realraum/luefterklappensteuerung/elektronik/lüfterklappenelektronik.pdf

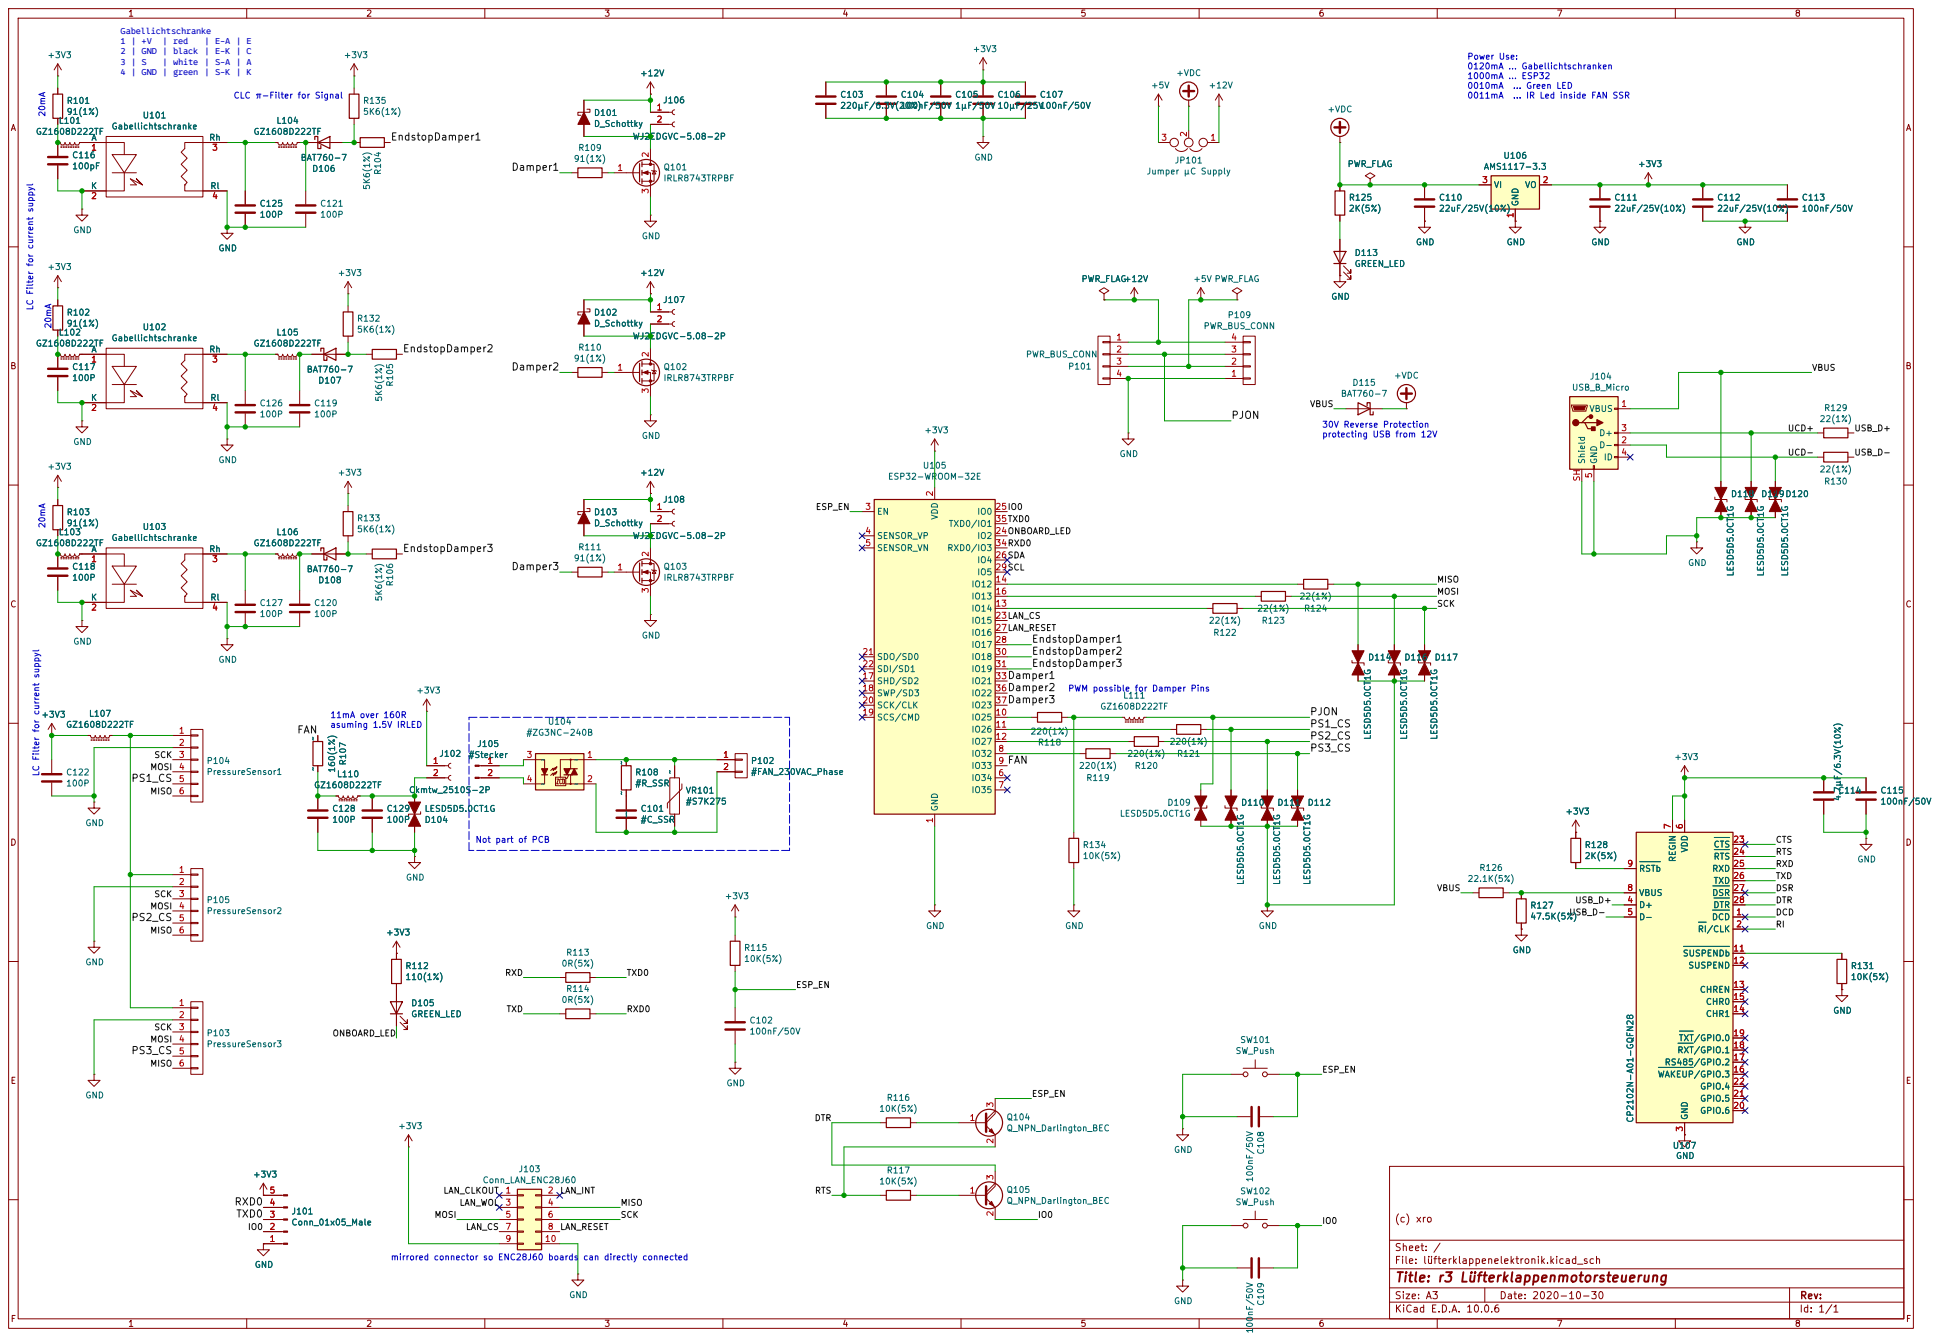
[picture p1: page 1]

0010mA ... Green LED
0011mA ... IR Led inside FAN SSR

protecting USB from 12V CLC π-Filter for Signal

Jumper µC Supply L101 GZ1608D222TF GND

LAN_CS LC Filter for current suppyl 20mALC Filter for current suppyl

4 P101 PWR_BUS_CONN 3 | | 2

PWM possible for Damper Pins VR101 #S7K275

Not part of PCB

Size: A3 | Rev: | F Date: 2020-10-30
KiCad E.D.A. 10.0.6 | Id: 1/1
