realraum/luefterklappensteuerung/elektronik/lüfterklappenelektronik.kicad_pcb

## KiCad design elektronik/lüfterklappenelektronik.kicad_pcb (2026-09-16)

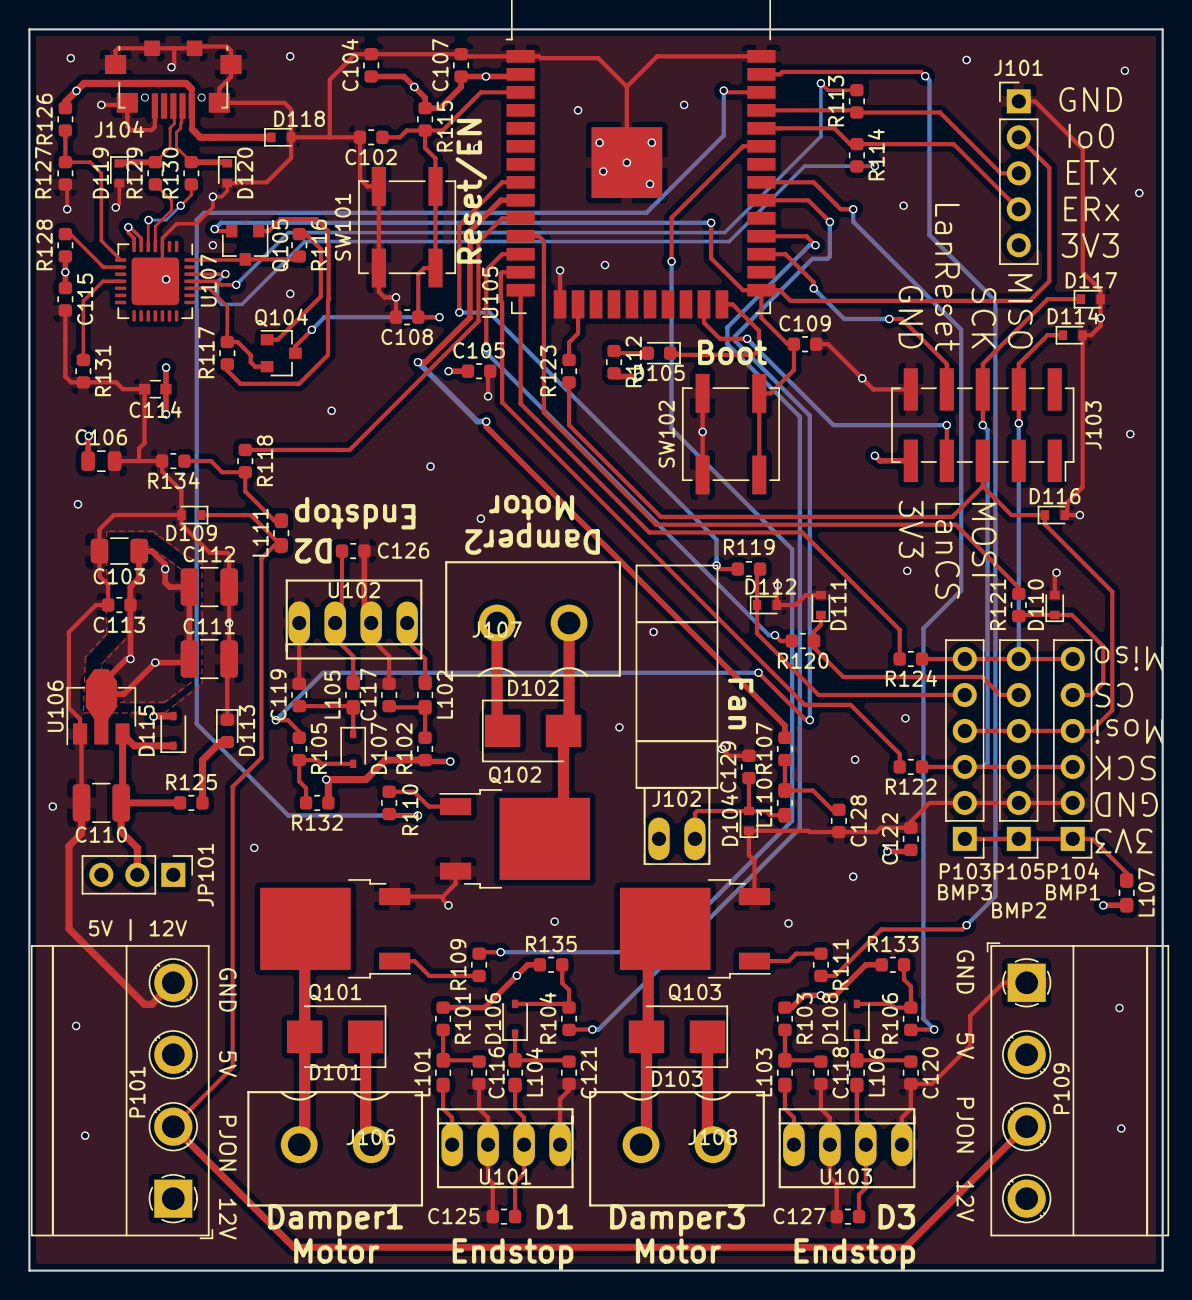
[picture p2: board lüfterklappenelektronik.kicad_pcb from above]

Board: 4 copper layers, 80.0 x 87.6 mm, 115 parts (0 on the bottom side), 74 nets.

Parts:
C102, C104, C107, C108, C109, C113, C115: 100nF/50V; C_0603_1608Metric
C103: 220µF/6.3V(20%); C_1206_3216Metric
C105: 1µF/50V; C_0603_1608Metric
C106: 10µF/25V; C_0805_2012Metric
C110, C111, C112: 22uF/25V(10%); C_1210_3225Metric
C114: 4.7µF/6.3V(10%); C_0603
C116: 100pF; C_0603_1608Metric
C117, C118, C119, C120, C121, C122, C125, C126, C127, C128, C129: 100P; C_0603_1608Metric
D101, D102, D103: D_Schottky; D_SMB
D104, D109, D110, D111, D112, D114, D116, D117, D118, D119, D120: LESD5D5.0CT1G; D_SOD-523
D105, D113: GREEN_LED; LED_0603_1608Metric
D106, D107, D108, D115: BAT760-7; D_SOD-323
J101: Conn_01x05_Male; PinHeader_1x05_P2.54mm_Vertical
J102: Ckmtw_2510S-2P; C30436_pinhead_1x2_vertical_P2.54
J103: Conn_LAN_ENC28J60; PinSocket_2x05_P2.54mm_Vertical_SMD
J104: USB_B_Micro; USB_Micro-B_C77238
J106, J107, J108: WJ2EDGVC-5.08-2P
JP101: Jumper µC Supply; PinHeader_1x03_P2.54mm_Vertical
L101, L102, L103, L104, L105, L106, L107, L110, L111: GZ1608D222TF; L_0603_1608Metric_Pad1.05x0.95mm_HandSolder
P101, P109: PWR_BUS_CONN; WJ2EDGRC-5.08-4P
P103: PressureSensor3; PinHeader_1x06_P2.54mm_Vertical
P104: PressureSensor1; PinHeader_1x06_P2.54mm_Vertical
P105: PressureSensor2; PinHeader_1x06_P2.54mm_Vertical
Q101, Q102, Q103: IRLR8743TRPBF; TO-252-2
Q104, Q105: Q_NPN_Darlington_BEC; SOT-23
R101, R102, R103, R109, R110, R111: 91(1%); R_0603_1608Metric
R104, R105, R106, R132, R133, R135: 5K6(1%); R_0603_1608Metric
R107: 160(1%); R_0603_1608Metric
R112: 110(1%); R_0603_1608Metric
R113, R114: 0R(5%); R_0603_1608Metric
R115, R116, R117, R131, R134: 10K(5%); R_0603_1608Metric
R118, R119, R120, R121: 220(1%); R_0603_1608Metric
R122, R123, R124, R129, R130: 22(1%); R_0603_1608Metric
R125, R128: 2K(5%); R_0603_1608Metric
R126: 22.1K(5%); R_0603_1608Metric
R127: 47.5K(5%); R_0603_1608Metric
SW101, SW102: SW_Push; SW_SPST_B3SL-1022P
U101, U102, U103: Gabellichtschranke; Ckmtw_2510S-4P
U105: ESP32-WROOM-32E; ESP32-WROOM-32
U106: AMS1117-3.3; SOT-89-3
U107: CP2102N-A01-GQFN28; QFN-28-1EP_5x5mm_P0.5mm_EP3.35x3.35mm

Connections:
+3V3: C103.1, C104.1, C105.1, C106.1, C107.1, C111.1, C112.1, C113.1, C114.1, C115.1, C122.1, J101.5, J102.1, J103.9, L107.2, R101.1, R102.1, R103.1, R112.2, R115.1, R128.1, R132.1, R133.1, R135.1, U105.2, U106.2, U107.6, U107.7
+5V: JP101.3, P101.3, P109.2
+12V: D101.1, D102.1, D103.1, J106.1, J107.1, J108.1, JP101.1, P101.1, P109.4
+VDC: C110.1, D115.1, JP101.2, R125.1, U106.3
/DTR: Q105.3, R116.2, U107.28
/Damper1: R109.2, U105.33
/Damper2: R110.2, U105.36
/Damper3: R111.2, U105.37
/ESP_EN: C102.1, C108.1, Q104.3, R115.2, SW101.2, U105.3
/EndstopDamper1: R104.1, U105.28
/EndstopDamper2: R105.1, U105.30
/EndstopDamper3: R106.1, U105.31
/FAN: R107.2, U105.9
/IO0: C109.1, J101.2, Q105.2, SW102.2, U105.25
/LAN_CS: J103.7, U105.23
/LAN_RESET: J103.8, U105.27
/MISO: D114.1, J103.4, P103.6, P104.6, P105.6, R124.1
/MOSI: D116.1, J103.5, P103.4, P104.4, P105.4, R123.1
/ONBOARD_LED: D105.1, U105.24
/PJON: D109.1, L111.1, P101.2, P109.3
/PS1_CS: D110.1, P104.5, R121.1
/PS2_CS: D111.1, P105.5, R120.1
/PS3_CS: D112.1, P103.5, R119.1
/RTS: Q104.2, R117.2, U107.24
/RXD: R113.2, U107.25
/RXD0: J101.4, R114.1, U105.34
/SCK: D117.1, J103.6, P103.3, P104.3, P105.3, R122.1
/TXD: R114.2, U107.26
/TXD0: J101.3, R113.1, U105.35
/UCD+: D119.1, J104.3, R129.2
/UCD-: D120.1, J104.2, R130.2
/USB_D+: R129.1, U107.4
/USB_D-: R130.1, U107.5
/VBUS: D115.2, D118.1, J104.1, R126.2
GND: C102.2, C103.2, C104.2, C105.2, C106.2, C107.2, C108.2, C109.2, C110.2, C111.2, C112.2, C113.2, C114.2, C115.2, C116.2, C117.2, C118.2, C119.2, C120.2, C121.2, C122.2, C125.2, C126.2, C127.2, C128.2, C129.2, D104.1, D109.2, D110.2, D111.2, D112.2, D113.1, D114.2, D116.2, D117.2, D118.2, D119.2, D120.2, J101.1, J103.10, J104.5, J104.6, P101.4, P103.2, P104.2, P105.2, P109.1, Q101.3, Q102.3, Q103.3, R127.2, R131.2, R134.2, SW101.1, SW102.1, U101.2, U101.4, U102.2, U102.4, U103.2, U103.4, U105.1, U105.15, U105.38, U105.39, U106.1, U107.3, U107.29
unnamed: C116.1, L101.2, R101.2
unnamed: C117.1, L102.2, R102.2
unnamed: C118.1, L103.2, R103.2
unnamed: C119.1, D107.1, L105.1
unnamed: C120.1, D108.1, L106.1
unnamed: C121.1, D106.1, L104.1
unnamed: C125.1, L104.2, U101.3
unnamed: C126.1, L105.2, U102.3
unnamed: C127.1, L106.2, U103.3
unnamed: C128.1, L110.2, R107.1
unnamed: C129.1, D104.2, J102.2, L110.1
unnamed: D101.2, J106.2, Q101.2
unnamed: D102.2, J107.2, Q102.2
unnamed: D103.2, J108.2, Q103.2
unnamed: D105.2, R112.1
unnamed: D106.2, R104.2, R135.2
unnamed: D107.2, R105.2, R132.2
unnamed: D108.2, R106.2, R133.2
unnamed: D113.2, R125.2
unnamed: L101.1, U101.1
unnamed: L102.1, U102.1
unnamed: L103.1, U103.1
unnamed: L107.1, P103.1, P104.1, P105.1
unnamed: L111.2, R118.2, R134.1
unnamed: Q101.1, R109.1
unnamed: Q102.1, R110.1
unnamed: Q103.1, R111.1
unnamed: Q104.1, R116.1
unnamed: Q105.1, R117.1
unnamed: R118.1, U105.10
unnamed: R119.2, U105.8
unnamed: R120.2, U105.12
unnamed: R121.2, U105.11
unnamed: R122.2, U105.13
unnamed: R123.2, U105.16
unnamed: R124.2, U105.14
unnamed: R126.1, R127.1, U107.8
unnamed: R128.2, U107.9
unnamed: R131.1, U107.11
