realraum/luefterklappensteuerung/(commit log)

2021-03-21 usb d- d+ bugfix
    [lüfterklappenelektronik.kicad_pcb, lüfterklappenelektronik.sch]
2026-05-07 custom calibration
2026-05-07 naive homeassistant controlled ventilation pcb
2026-09-16 kicad v10 und pdf
    [lüfterklappenelektronik.kicad_pcb]
