realraum/luefterklappensteuerung/(notices)

Notices in the files:
firmware/dampercontrol/src/comm.cpp:
Damper Control Firmware is free software: you can redistribute it and/or modify
it under the terms of the GNU General Public License as published by
the Free Software Foundation, either version 3 of the License, or
any later version.
